fanfanlatulipe26/Tint_Hiker/Tiny_Hiker/mpu_dmp_mini_podometre.h

/*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
    You should have received a copy of the GNU General Public License
    along with this program.  If not, see <https://www.gnu.org/licenses/>.
*/
#include "tiny_hiker.h"
// 1/1/2021 OK with MPU9250 and podometer.
// Part of the reset/init sequence from Jeff Rowberg MPU6050 library, in MPU6050_6Axis_MotionApps_V6_12.h
/* The following functions must be defined for this platform:
  i2c_write(unsigned char slave_addr, unsigned char reg_addr,
       unsigned char length, unsigned char const *data)
  i2c_read(unsigned char slave_addr, unsigned char reg_addr,
       unsigned char length, unsigned char *data)
  delay_ms(unsigned long num_ms)
  
*/
// user functions

int mpu_init_load_firmware() ;
int mpu_init_load_firmware_EEPROM(int eepromAddress);
/* Pedometer functions. */
int dmp_get_pedometer_step_count(unsigned long *count);
int dmp_set_pedometer_step_count(unsigned long count);
int dmp_get_pedometer_walk_time(unsigned long *time);
int dmp_set_pedometer_walk_time(unsigned long time);

// internal functions.
int mpu_load_firmware(unsigned short length, const unsigned char *firmware,
                      unsigned short start_addr, unsigned short sample_rate);
int mpu_load_firmware_EEPROM(unsigned short length, int eepromAddress ,
                             unsigned short start_addr, unsigned short sample_rate);

void reset_mpu() ;
void mpu_cfg_gyro_fifo_DMP();
void writeByteEEPROM(int deviceaddress, unsigned int eeaddress, byte data );
void writeStringEEPROM(int deviceaddress, unsigned int eeaddress, byte* data, unsigned int num_chars);
void readStringEEPROM(int deviceaddress, unsigned int eeaddress,
                      unsigned char* data, unsigned int num_chars);
int mpu_read_mem(unsigned short mem_addr, unsigned short length,
                 unsigned char *data);
int mpu_write_mem(unsigned short mem_addr, unsigned short length,
                  unsigned char *data);


#define i2c_write   !I2Cdev::writeBytes
#define i2c_read    !I2Cdev::readBytes
#define delay_ms    delay

//#define addr 0x68  // i2C addr of MPU
//#define addr 0x69  // i2C addr of MPU
#define addr MPU9250_I2C_address


#define gyro_cfg       0x1B   // registre GYRO_CONFIG
#define user_ctrl      0x6A   // registre USER_CTRL   (enable /desable FIFO ...)
#define pwr_mgmt_1     0x6B   // registre Power Management 1 (dec 107)
#define pwr_mgmt_2     0x6C   // register Power Management 2 ( 108)
#define bank_sel       0x6D   // registre caché. Selection bank pour écriture / lecture mémoire mpu
#define mem_r_w        0x6F   // registre caché. accés écriture / lecture mémoire mpu
#define prgm_start_h   0x70   // registres cachés 0x70 0x71 program start address

#define D_PEDSTD_STEPCTR        (768 + 0x60)    // memoire cachée pour le podomètre ....... Change suivant la releae du microcode DMP ???
#define D_PEDSTD_TIMECTR        (964)

#define BIT_RESET           (0x80)
#define BIT_FIFO_EN         (0x40)
#define BIT_DMP_EN          (0x80)   // commande cachée


#define BIT_LPA_CYCLE       (0x20)
#define BIT_TEMP_DIS  0x08   // disable temperature
#define BIT_STBY_XG         (0x04)   // stand by for gyro
#define BIT_STBY_YG         (0x02)
#define BIT_STBY_ZG         (0x01)
#define BIT_STBY_XYZG       (BIT_STBY_XG | BIT_STBY_YG | BIT_STBY_ZG)

/* Low-power accel wakeup rates. for MP6050*/
enum lp_accel_rate_e {
  INV_LPA_1_25HZ,
  INV_LPA_5HZ,
  INV_LPA_20HZ,
  INV_LPA_40HZ
};

/* Clock sources. */
enum clock_sel_e {
  INV_CLK_INTERNAL = 0,
  INV_CLK_PLL,
  NUM_CLK
};
/* Full scale ranges. */
enum gyro_fsr_e {
  INV_FSR_250DPS = 0,
  INV_FSR_500DPS,
  INV_FSR_1000DPS,
  INV_FSR_2000DPS,
  NUM_GYRO_FSR
};


#define DMP_SAMPLE_RATE     (200)   // ?????????????????????????????????????????????????????????????????????????????????????????????

#define DMP_CODE_SIZE           (3062)
// code 5.1.3
//static const unsigned char dmp_memory[DMP_CODE_SIZE] = {
//  const unsigned char DMPfirm[DMP_CODE_SIZE] PROGMEM = {
const unsigned char dmp_memory[DMP_CODE_SIZE] PROGMEM = {
  /* bank # 0 */
  0x00, 0x00, 0x70, 0x00, 0x00, 0x00, 0x00, 0x24, 0x00, 0x00, 0x00, 0x02, 0x00, 0x03, 0x00, 0x00,
  0x00, 0x65, 0x00, 0x54, 0xff, 0xef, 0x00, 0x00, 0xfa, 0x80, 0x00, 0x0b, 0x12, 0x82, 0x00, 0x01,
  0x03, 0x0c, 0x30, 0xc3, 0x0e, 0x8c, 0x8c, 0xe9, 0x14, 0xd5, 0x40, 0x02, 0x13, 0x71, 0x0f, 0x8e,
  0x38, 0x83, 0xf8, 0x83, 0x30, 0x00, 0xf8, 0x83, 0x25, 0x8e, 0xf8, 0x83, 0x30, 0x00, 0xf8, 0x83,
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
  0xac, 0x8c, 0x9c, 0x0c, 0x30, 0xac, 0xde, 0xd0, 0xde, 0xff, 0xd8, 0x8c, 0x9c, 0xac, 0xd0, 0x10,
  0xac, 0xde, 0x80, 0x92, 0xa2, 0xf2, 0x4c, 0x82, 0xa8, 0xf1, 0xca, 0xf2, 0x35, 0xf1, 0x96, 0x88,
  0xa6, 0xd9, 0x00, 0xd8, 0xf1, 0xff
};

static const unsigned short sStartAddress = 0x0400;

void reset_mpu() {
  // sequence comming mainly from Jeff Rowberg MPU6050 library, in MPU6050_6Axis_MotionApps_V6_12.h
  unsigned char data;
  /* Reset device. */
  data = BIT_RESET;
  i2c_write(addr, pwr_mgmt_1, 1, &data);  //PWR_MGMT_1: reset with 100ms delay
  delay_ms(100);
  data = 0x07;
  i2c_write(addr, 104, 1, &data);  // SIGNA_PATH_RESET reg 104  -0x68)
  delay_ms(100);
  data = 0x07;
  i2c_write(addr, 0x6A, 1, &data);
  delay_ms(100);
  i2c_write(addr, 0x6B, 1, &(data = 0x01)); // 1000 0001 PWR_MGMT_1:Clock Source Select PLL_X_gyro
  i2c_write(addr, 0x38, 1, &(data = 0x00)); // 0000 0000 INT_ENABLE: no Interrupt
  i2c_write(addr, 0x23, 1, &(data = 0x00)); // 0000 0000 MPU FIFO_EN: (all off) Using DMP's FIFO instead
  i2c_write(addr, 0x1C, 1, &(data = 0x00)); // 0000 0000 ACCEL_CONFIG: 0 =  Accel Full Scale Select: 2g
  i2c_write(addr, 0x37, 1, &(data = 0x80)); // 1001 0000 INT_PIN_CFG: ACTL The logic level for int pin is active low. and interrupt status bits are cleared on any read
  i2c_write(addr, 0x6B, 1, &(data = 0x01)); // 0000 0001 PWR_MGMT_1: Clock Source Select PLL_X_gyro
  i2c_write(addr, 0x19, 1, &(data = 0x04)); // 0000 0100 SMPLRT_DIV: Divides the internal sample rate 400Hz ( Sample Rate = Gyroscope Output Rate / (1 + SMPLRT_DIV))
  i2c_write(addr, 0x1A, 1, &(data = 0x01)); // 0000 0001 CONFIG: Digital Low Pass Filter (DLPF) Configuration 188HZ  //Im betting this will be the beat
}

int mpu_init_load_firmware() {
  reset_mpu();
  if (mpu_load_firmware(DMP_CODE_SIZE, dmp_memory, sStartAddress, DMP_SAMPLE_RATE)) return -1;
  mpu_cfg_gyro_fifo_DMP();
  return 0;
}

// return 0 if OK, -1 if error
int mpu_init_load_firmware_EEPROM(int eepromAddress) {
  reset_mpu();
  if (mpu_load_firmware_EEPROM(DMP_CODE_SIZE, eepromAddress, sStartAddress, DMP_SAMPLE_RATE)) return -1;
  mpu_cfg_gyro_fifo_DMP();
  return 0;
}

void mpu_cfg_gyro_fifo_DMP() {
  unsigned char data;

  // No need of the gyroscope for pedometer.Put gyro in standby mode and save power (arround 3mA)
  // No success with the init sequence in documentation MPU-6000 and MPU-6050 Register Map and Descriptions,
  // p 42 (register 6C/108 PWR_MGMT_2) to put the MPU-60X0 into Accelerometer Only Low Power Mode. ...
  // data =  BIT_STBY_XYZG;  // Ok pour podomètre si gyro en standby: testé OK.
  // i2c_write(addr, pwr_mgmt_2, 1, &data);
  //Reg 106 (6A) user control
  //for the pedometer we just need to enable DMP (reserved bit). No need of FIFO
  data =   BIT_DMP_EN ; //enable DMP  B10000000
  i2c_write(addr, user_ctrl, 1, &data);
}

// return 0 if OK, -2 if error
int mpu_load_firmware(unsigned short length, const unsigned char *firmware,
                      unsigned short start_addr, unsigned short sample_rate)
{
  unsigned short ii;
  unsigned short this_write;
  /* Must divide evenly into st.hw->bank_size to avoid bank crossings. */
#define LOAD_CHUNK  (16)
  unsigned char cur[LOAD_CHUNK], tmp[2];
  unsigned char progBuffer[LOAD_CHUNK];
  for (ii = 0; ii < length; ii += this_write) {
    this_write = min(LOAD_CHUNK, length - ii);
    for (int progIndex = 0; progIndex < this_write; progIndex++)
      progBuffer[progIndex] = pgm_read_byte(firmware + ii + progIndex);
    mpu_write_mem(ii, this_write, progBuffer);

    mpu_read_mem(ii, this_write, cur);
    if (memcmp(progBuffer, cur, this_write))return -2;
  }
  /* Set program start address. */
  //Regs 112 and 113 (70 & 71) have DMP program start address $0400.  Registres cachés .....
  tmp[0] = start_addr >> 8;
  tmp[1] = start_addr & 0xFF;
  i2c_write(addr, prgm_start_h, 2, tmp);
  return 0;
}

// return 0 if OK, -2 if error
int mpu_load_firmware_EEPROM(unsigned short length, int eepromAddress ,
                             unsigned short start_addr, unsigned short sample_rate)
{
  unsigned short ii;
  unsigned short this_write;
  /* Must divide evenly into st.hw->bank_size to avoid bank crossings. */
#define LOAD_CHUNK  (16)
  unsigned char cur[LOAD_CHUNK], tmp[2];
  unsigned char progBuffer[LOAD_CHUNK];
  for (ii = 0; ii < length; ii += this_write) {
    this_write = min(LOAD_CHUNK, length - ii);
    readStringEEPROM( eepromAddress, ii, progBuffer, this_write);
    mpu_write_mem(ii, this_write, progBuffer);
    mpu_read_mem(ii, this_write, cur);
    if (memcmp(progBuffer, cur, this_write))return -2;
  }
  /* Set program start address. */
  //Regs 112 and 113 (70 & 71) have DMP program start address $0400.  Registres cachés .....
  tmp[0] = start_addr >> 8;
  tmp[1] = start_addr & 0xFF;
  i2c_write(addr, prgm_start_h, 2, tmp);
  return 0;
}

/*
   Ecriture de 1 octet. Pas de containte d'adresse
*/
void writeByteEEPROM(int deviceaddress, unsigned int eeaddress, byte data )
{
  Wire.beginTransmission(deviceaddress);
  Wire.write((int)(eeaddress >> 8));   // MSB
  Wire.write((int)(eeaddress & 0xFF)); // LSB
  Wire.write(data);
  Wire.endTransmission();
  delay(5);
}
/*
   Ecriture de 16 octets.
   NE DOIT PAS TRAVERSER UNE PAGE
   PAS DE VERIFICATION
*/
void writeStringEEPROM(int deviceaddress, unsigned int eeaddress, byte* data, unsigned int num_chars)
{
  Wire.beginTransmission(deviceaddress);
  Wire.write((int)((eeaddress) >> 8));   // MSB
  Wire.write((int)((eeaddress) & 0xFF)); // LSB
  for (unsigned int i = 0; i < num_chars; i++) {
    Wire.write((byte) data[i]);
  }
  Wire.endTransmission();
  delay(6);  // needs 5ms for page write
}
/*
   Lecture d'une suite de charactère.
   16 byte max
   Pas de containtes d'adresse
*/
void readStringEEPROM(int deviceaddress, unsigned int eeaddress,
                      unsigned char* data, unsigned int num_chars)
{
  unsigned char i = 0;
  Wire.beginTransmission(deviceaddress);
  Wire.write((int)(eeaddress >> 8));   // MSB
  Wire.write((int)(eeaddress & 0xFF)); // LSB
  Wire.endTransmission();
  Wire.requestFrom(deviceaddress, num_chars);
  while (Wire.available()) data[i++] = Wire.read();

}

int mpu_read_mem(unsigned short mem_addr, unsigned short length,
                 unsigned char *data)
{
  unsigned char tmp[2];
  tmp[0] = (unsigned char)(mem_addr >> 8);
  tmp[1] = (unsigned char)(mem_addr & 0xFF);

  i2c_write(addr, bank_sel, 2, tmp);
  i2c_read(addr, mem_r_w, length, data);
  return 0;
}

int mpu_write_mem(unsigned short mem_addr, unsigned short length,
                  unsigned char *data)
{
  unsigned char tmp[2];
  tmp[0] = (unsigned char)(mem_addr >> 8);
  tmp[1] = (unsigned char)(mem_addr & 0xFF);
  i2c_write(addr, bank_sel, 2, tmp);
  i2c_write(addr, mem_r_w, length, data);
  return 0;
}



/**
      @brief      Get current step count.
      @param[out] count   Number of steps detected.
      @return     0 if successful.
*/
int dmp_get_pedometer_step_count(unsigned long * count)
{
  unsigned char tmp[4];
  mpu_read_mem(D_PEDSTD_STEPCTR, 4, tmp);
  count[0] = ((unsigned long)tmp[0] << 24) | ((unsigned long)tmp[1] << 16) |
             ((unsigned long)tmp[2] << 8) | tmp[3];
  return 0;
}

/**
    @brief      Overwrite current step count.
    WARNING: This function writes to DMP memory and could potentially encounter
    a race condition if called while the pedometer is enabled.
    @param[in]  count   New step count.
    @return     0 if successful.
*/
int dmp_set_pedometer_step_count(unsigned long count)
{
  unsigned char tmp[4];
  tmp[0] = (unsigned char)((count >> 24) & 0xFF);
  tmp[1] = (unsigned char)((count >> 16) & 0xFF);
  tmp[2] = (unsigned char)((count >> 8) & 0xFF);
  tmp[3] = (unsigned char)(count & 0xFF);
  return mpu_write_mem(D_PEDSTD_STEPCTR, 4, tmp);
}

/**
    @brief      Get duration of walking time.
    @param[in]  time    Walk time in milliseconds.
    @return     0 if successful.
*/
int dmp_get_pedometer_walk_time(unsigned long * time)
{
  unsigned char tmp[4];
  mpu_read_mem(D_PEDSTD_TIMECTR, 4, tmp);
  time[0] = (((unsigned long)tmp[0] << 24) | ((unsigned long)tmp[1] << 16) |
             ((unsigned long)tmp[2] << 8) | tmp[3]) * 20;
  return 0;
}

/**
    @brief      Overwrite current walk time.
    WARNING: This function writes to DMP memory and could potentially encounter
    a race condition if called while the pedometer is enabled.
    @param[in]  time    New walk time in milliseconds.
*/
int dmp_set_pedometer_walk_time(unsigned long time)
{
  unsigned char tmp[4];
  time /= 20;
  tmp[0] = (unsigned char)((time >> 24) & 0xFF);
  tmp[1] = (unsigned char)((time >> 16) & 0xFF);
  tmp[2] = (unsigned char)((time >> 8) & 0xFF);
  tmp[3] = (unsigned char)(time & 0xFF);
  return mpu_write_mem(D_PEDSTD_TIMECTR, 4, tmp);
}
