fanfanlatulipe26/Tint_Hiker/Tiny_Hiker/Die_2.c

/*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
    You should have received a copy of the GNU General Public License
    along with this program.  If not, see <https://www.gnu.org/licenses/>.
*/
#include <avr/pgmspace.h>

//const unsigned char Die [] PROGMEM = {
  const uint8_t Die_2[] PROGMEM={
0xff, 0xff, 0xff, 0xff, 0xff, 0xff, 0xff, 0xff, 0xff, 0xff, 0xff, 0xff, 0xff, 0xff, 0xff, 0xff, 
0xff, 0xff, 0xff, 0xff, 0x87, 0xff, 0xff, 0xff, 0xff, 0xf8, 0x47, 0xff, 0xff, 0xff, 0xff, 0xff, 
0xff, 0xff, 0xf8, 0x00, 0x87, 0xff, 0xff, 0xff, 0x0e, 0x18, 0x47, 0xff, 0xff, 0xff, 0xff, 0xff, 
0xff, 0xff, 0xf8, 0x00, 0xff, 0xff, 0xff, 0xff, 0x0e, 0x1f, 0xc7, 0xff, 0xff, 0xff, 0xff, 0xff, 
0xff, 0xff, 0xf8, 0x00, 0xff, 0xff, 0xff, 0xff, 0x0e, 0x1f, 0xc7, 0xff, 0xff, 0xff, 0xff, 0xff, 
0xff, 0xff, 0xff, 0x8f, 0x84, 0x43, 0x0c, 0x3f, 0x0e, 0x18, 0x46, 0x1c, 0x1c, 0x4f, 0xff, 0xff, 
0xff, 0xff, 0xff, 0x8f, 0x84, 0x01, 0x0c, 0x3f, 0x00, 0x18, 0x44, 0x30, 0x0c, 0x0f, 0xff, 0xff, 
0xff, 0xff, 0xff, 0x8f, 0x84, 0x61, 0x8c, 0x7f, 0x00, 0x18, 0x44, 0x71, 0x84, 0x7f, 0xff, 0xff, 
0xff, 0xff, 0xff, 0x8f, 0x84, 0x61, 0x80, 0x7f, 0x00, 0x18, 0x40, 0xf0, 0x04, 0x7f, 0xff, 0xff, 
0xff, 0xff, 0xff, 0x8f, 0x84, 0x61, 0xc0, 0xff, 0x0e, 0x18, 0x40, 0x70, 0x04, 0x7f, 0xff, 0xff, 
0xff, 0xff, 0xff, 0x8f, 0x84, 0x61, 0xc0, 0xff, 0x0e, 0x18, 0x40, 0x31, 0xf4, 0x7f, 0xff, 0xff, 
0xff, 0xff, 0xff, 0x8f, 0x84, 0x61, 0xc0, 0xff, 0x0e, 0x18, 0x46, 0x10, 0x04, 0x7f, 0xff, 0xff, 
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
0xff, 0xff, 0xff, 0xff, 0xff, 0xff, 0xfb, 0xff, 0xff, 0xff, 0xe0, 0x00, 0x00, 0x00, 0x00, 0x00, 
0xff, 0xff, 0xff, 0xfc, 0xff, 0xff, 0xf9, 0xff, 0xff, 0xff, 0xc0, 0x00, 0x00, 0x00, 0x00, 0x00, 
0xff, 0xff, 0xff, 0xf8, 0x7f, 0xff, 0xf9, 0xcb, 0xff, 0xff, 0xc0, 0x00, 0x00, 0x00, 0x00, 0x00, 
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

};
